AllDigital33/diyDAQ/Schematic.png

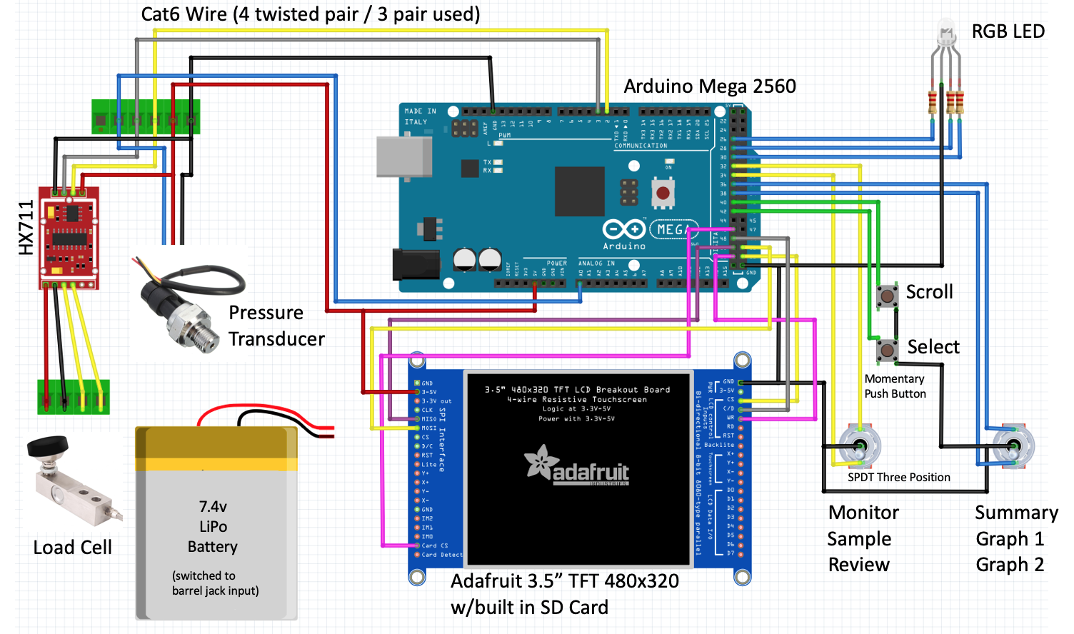
Schematic.png
