AllDigital33/diyDAQ/IMG_4675.jpeg

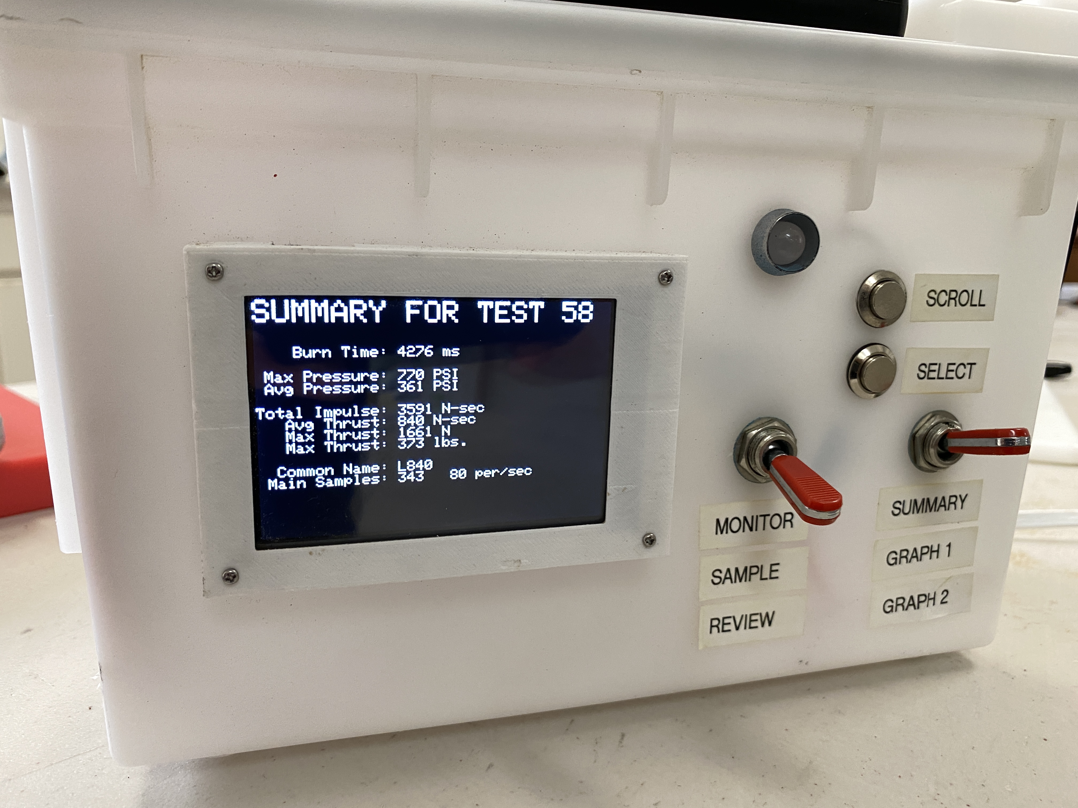
IMG_4675.jpeg
