AllDigital33/diyDAQ/IMG_4224.jpeg

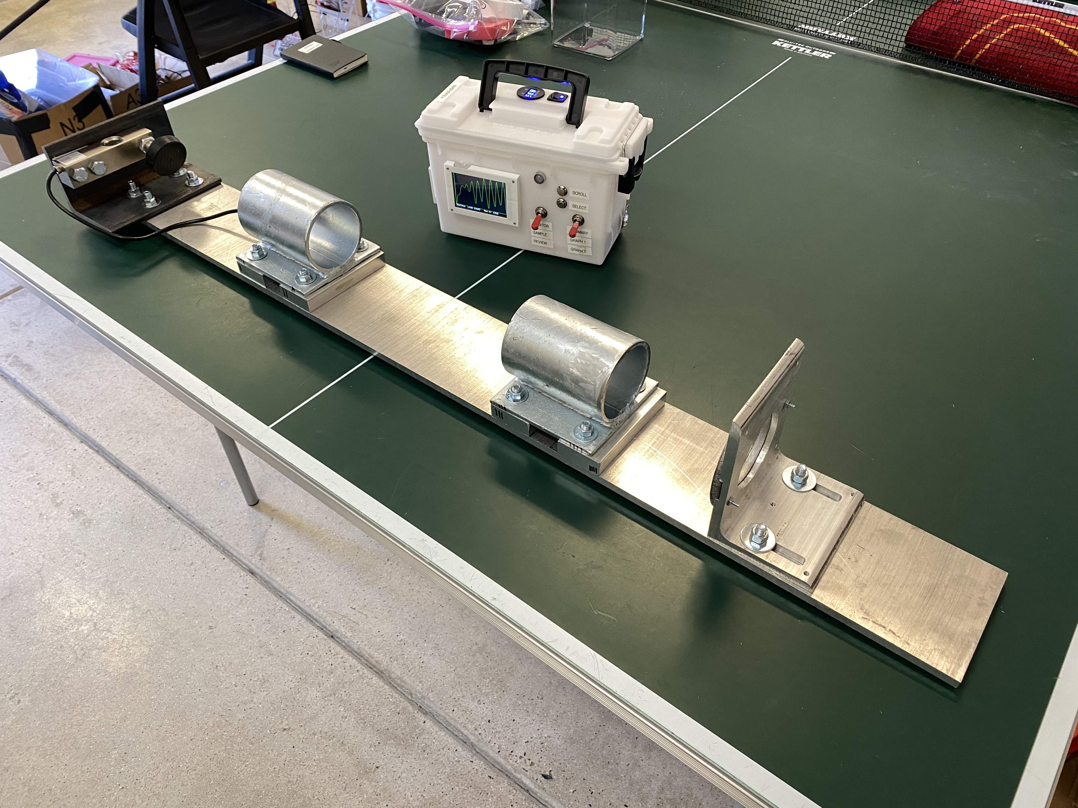
IMG_4224.jpeg
